ZenPCB/Raptors/README.md

# Raptors
387MHz to 464Mhz transceiver USB dongle

top_view
