ZenPCB/Raptors/KiCad/3d_models/Molex 480372-200.step

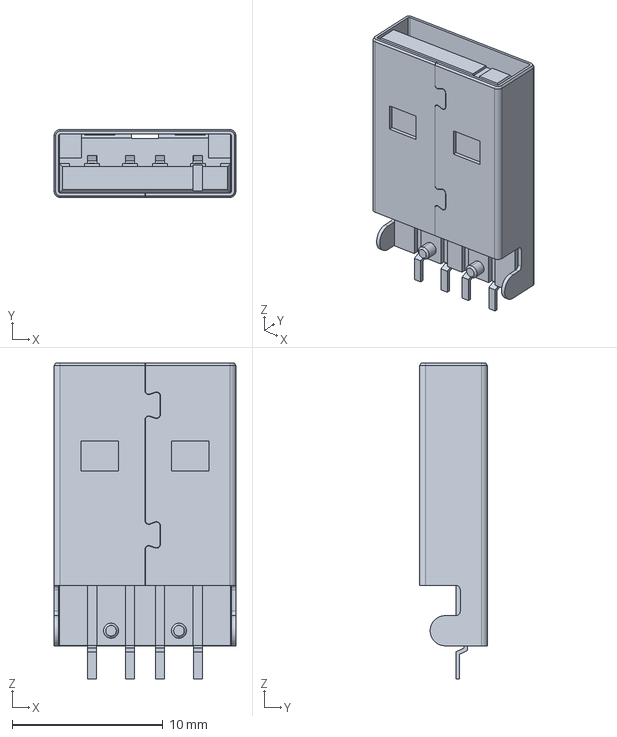
[picture p1: CAD file, 2018-08-28]
KiCad/3d_models/Molex 480372-200.step
12.1 x 4.50 x 21.0 mm
