ZenPCB/Raptors/KiCad/EFM32HG308F64G-A-QFN24/3D/EFM32HG308F64G-A-QFN24.stp

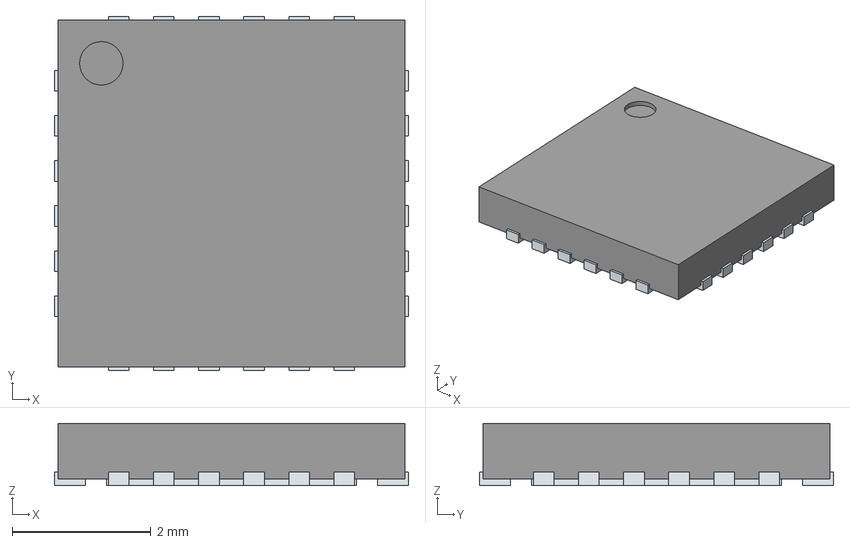
[picture p2: CAD file, 2018-09-10]
KiCad/EFM32HG308F64G-A-QFN24/3D/EFM32HG308F64G-A-QFN24.stp
5.10 x 5.10 x 0.9 mm
ThermalPin
PinsArrayLR
PinsArrayTB
