ZenPCB/Raptors/KiCad/LIB_Si4012-C1001GT/3D/Si4012-C1001GT.stp

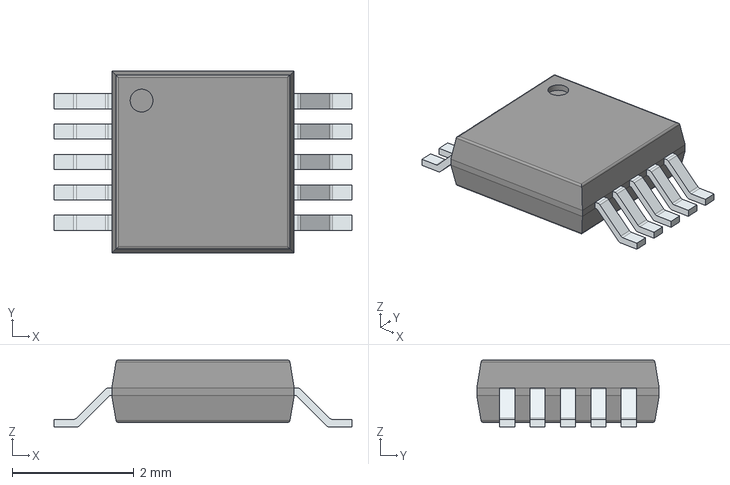
[picture p3: CAD file, 2018-08-01]
KiCad/LIB_Si4012-C1001GT/3D/Si4012-C1001GT.stp
4.90 x 3.00 x 1.10 mm
PinsArrayLR
