ZenPCB/Raptors/(list of files, cad)

Other CAD files:
KiCad/EFM32HG308F64G-A-QFN24/3D/EFM32HG308F64G-A-QFN24.stl
KiCad/LIB_Si4012-C1001GT/3D/Si4012-C1001GT.stl
