ZenPCB/Raptors/RapTorS.pdf

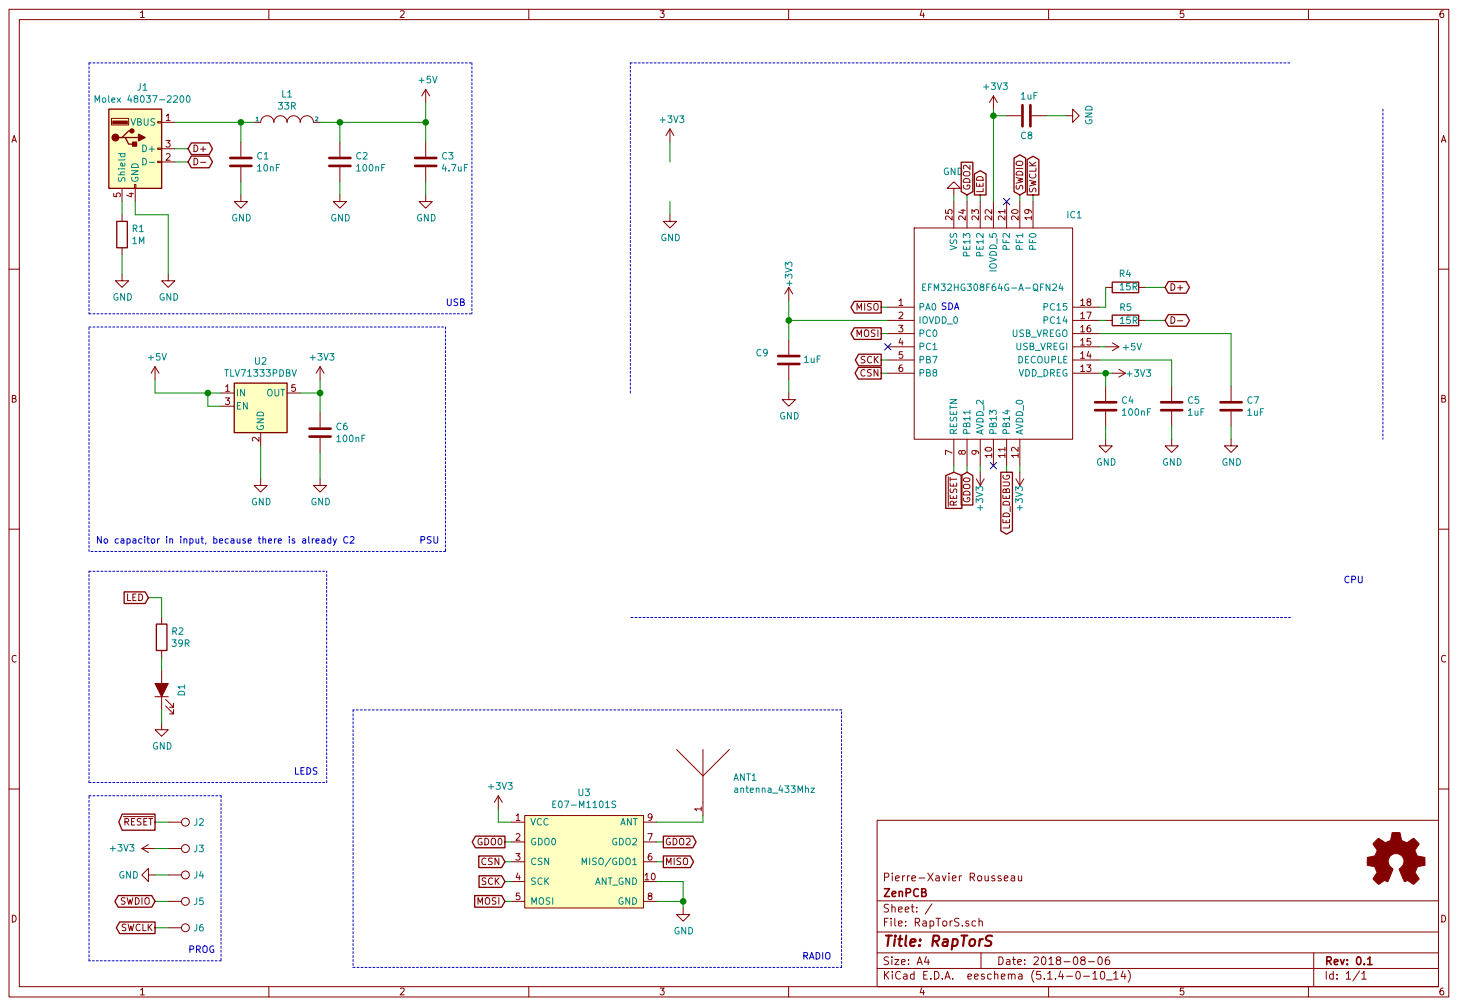
[picture p4: page 1]

Pierre-Xavier Rousseau
File: RapTorS.sch Sheet: / ZenPCB
