ZenPCB/Raptors/KiCad/RapTorS.kicad_pcb

## KiCad design KiCad/RapTorS.kicad_pcb (2019-10-07)

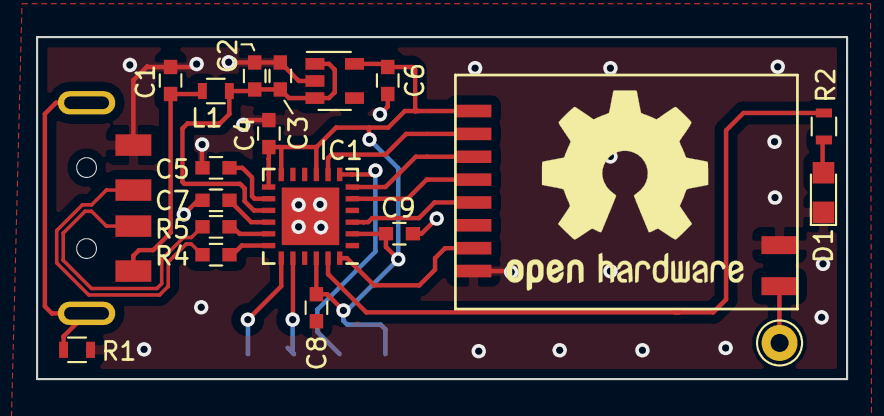
[picture p5: board RapTorS.kicad_pcb from above]

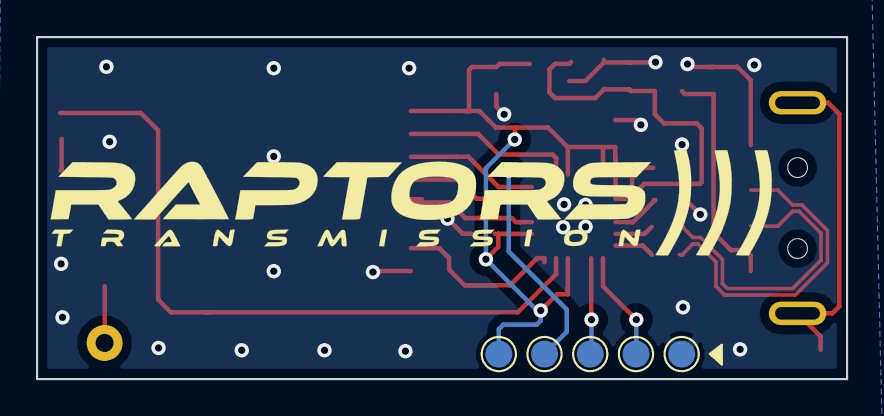
[picture p6: board RapTorS.kicad_pcb from below]

Board: 2 copper layers, 45.0 x 19.0 mm, 26 parts (6 on the bottom side), 23 nets.

Parts:
ANT1: antenna_433Mhz; Pin_d1.0mm_L10.0mm
C1: 10nF; C_0603
C2, C4, C6: 100nF; C_0603
C3: 4.7uF; C_0603
C5, C7, C8, C9: 1uF; C_0603
D1: LED_ALT; LED_0805
IC1: EFM32HG308F64G-A-QFN24; QFN-24-1EP_5x5mm_Pitch0.65mm
J1: Molex 48037-2200; MOLEX_USB_48037-2200
J2, J3, J4, J5, J6: TestPoint; Test_Point_Pad_d1.5mm
L1: 33R; L_0603
R1: 1M; R_0603
R2: 39R; R_0603
R4, R5: 15R; C_0603
RAPTORS: LOGO; Logo
U2: TLV71333PDBV; SOT-23-5
U3: E07-M1101S

Connections:
+3V3: C4.1, C6.1, C8.2, C9.2, IC1.2, IC1.9, IC1.12, IC1.13, IC1.22, J3.1, U2.5, U3.1
+5V: C2.1, C3.1, IC1.15, L1.2, U2.1, U2.3
CSN: IC1.6, U3.3
D+: J1.3, R4.2
D-: J1.2, R5.1
GDO0: IC1.8, U3.2
GDO2: IC1.24, U3.7
GND: C1.2, C2.2, C3.2, C4.2, C5.2, C6.2, C7.2, C8.1, C9.1, D1.1, IC1.25, J1.4, J4.1, R1.2, U2.2, U3.8, U3.10
LED: IC1.23, R2.1
MISO: IC1.4, U3.6
MOSI: IC1.3, U3.5
unnamed: ANT1.1, U3.9
unnamed: C1.1, J1.1, L1.1
unnamed: C5.1, IC1.14
unnamed: C7.1, IC1.16
unnamed: D1.2, R2.2
unnamed: IC1.17, R5.2
unnamed: IC1.18, R4.1
unnamed: J1.5, R1.1
SCK: IC1.5, U3.4
SWCLK: IC1.19, J6.1
SWDIO: IC1.20, J5.1
~RESET: IC1.7, J2.1
