ZenPCB/Raptors/(commit log)

2018-03-15 inital commit, blank project
    [RapTorS.kicad_pcb, RapTorS.sch]
2018-08-01 add imported Si4012 component lib
    [Si4012-C1001GT.stl, Si4012-C1001GT.stp]
2018-08-22 new schematic with new version of KiCad and new E07 radio module
2018-08-22 annotate schematic
    [RapTorS.sch]
2018-08-22 set values for USB block
    [RapTorS.sch]
2018-08-22 set values for CPU block
    [RapTorS.sch]
2018-08-22 set values for PSU block
    [RapTorS.sch]
2018-08-22 every values OK
    [RapTorS.sch]
2018-08-22 add E07 footprint, associate all footprints
    [RapTorS.sch]
2018-08-23 update USB connector ref
    [RapTorS.sch]
2018-08-28 finish USB footprint
    [Molex 480372-200.step, RapTorS.sch]
2018-08-28 create PCB from schematic
    [RapTorS.kicad_pcb]
2018-08-28 first placement
    [RapTorS.kicad_pcb]
2018-08-28 placement second step
    [RapTorS.kicad_pcb, RapTorS.sch]
2018-08-29 routing OK
    [RapTorS.kicad_pcb]
2018-08-30 add the logo
    [RapTorS.kicad_pcb]
2018-08-30 update logo size
    [RapTorS.kicad_pcb]
2018-08-30 update 3D models
    [RapTorS.kicad_pcb]
2018-08-30 update 3D
    [RapTorS.kicad_pcb]
2018-08-30 change C3 to ceramic, in order to fit in the case
    [RapTorS.sch]
2018-08-30 update C3 on layout, generate gerber
    [RapTorS-B.Cu.gbr, RapTorS-B.Mask.gbr, RapTorS-B.Paste.gbr, RapTorS-B.SilkS.gbr, RapTorS-Edge.Cuts.gbr, RapTorS-F.Cu.gbr, RapTorS-F.Mask.gbr, RapTorS-F.Paste.gbr]
2018-08-30 add PCB dimentions
    [RapTorS.kicad_pcb]
2018-08-30 change PCB dimentions layer
    [RapTorS.kicad_pcb]
2018-09-01 odd OSHW logo
    [RapTorS.kicad_pcb]
2018-09-10 add EFM32HG308 lib - add new uController on schematic
    [EFM32HG308F64G-A-QFN24.stl, EFM32HG308F64G-A-QFN24.stp, RapTorS.sch]
2018-09-10 routing completed
    [RapTorS.kicad_pcb, RapTorS.sch]
2018-09-11 add 3D shapes
    [RapTorS.kicad_pcb]
2018-09-11 add missing footprint
    [RapTorS.kicad_pcb]
2018-09-11 move KiCad related files inside KiCad folder
    [EFM32HG308F64G-A-QFN24.stl, EFM32HG308F64G-A-QFN24.stp, Molex 480372-200.step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]
2018-09-12 correct pinout bug
    [RapTorS.kicad_pcb, RapTorS.sch]
2018-09-12 just move a via
    [RapTorS.kicad_pcb]
2018-09-12 harmonize resistors and capacitors footprints due to KiCad issue #11
    [RapTorS.kicad_pcb, RapTorS.sch]
2018-09-12 refill zones
    [RapTorS.kicad_pcb]
2018-09-12 update Gerber
    [RapTorS-B.Cu.gbr, RapTorS-B.Mask.gbr, RapTorS-B.Paste.gbr, RapTorS-B.SilkS.gbr, RapTorS-Edge.Cuts.gbr, RapTorS-F.Cu.gbr, RapTorS-F.Mask.gbr, RapTorS-F.Paste.gbr]
2018-09-18 add BOM with Farnell refs
    [BOM.csv]
2018-09-18 add Mouser ref
    [BOM.csv]
2019-05-13 update R2 to 50R
    [RapTorS.sch]
2019-05-13 update R2 to 56R (from E12 serie)
    [RapTorS.sch]
2019-09-19 add schematic PDF
    [RapTorS.sch]
2019-10-07 correct SPI pinout, add a led and a switch
    [RapTorS.kicad_pcb, RapTorS.sch]
2019-10-07 change wire antenna by SMA connector
    [RapTorS.sch]
